nicho810/XIAO-PowerBread/Docs/Images/webFlashTools/1.webp

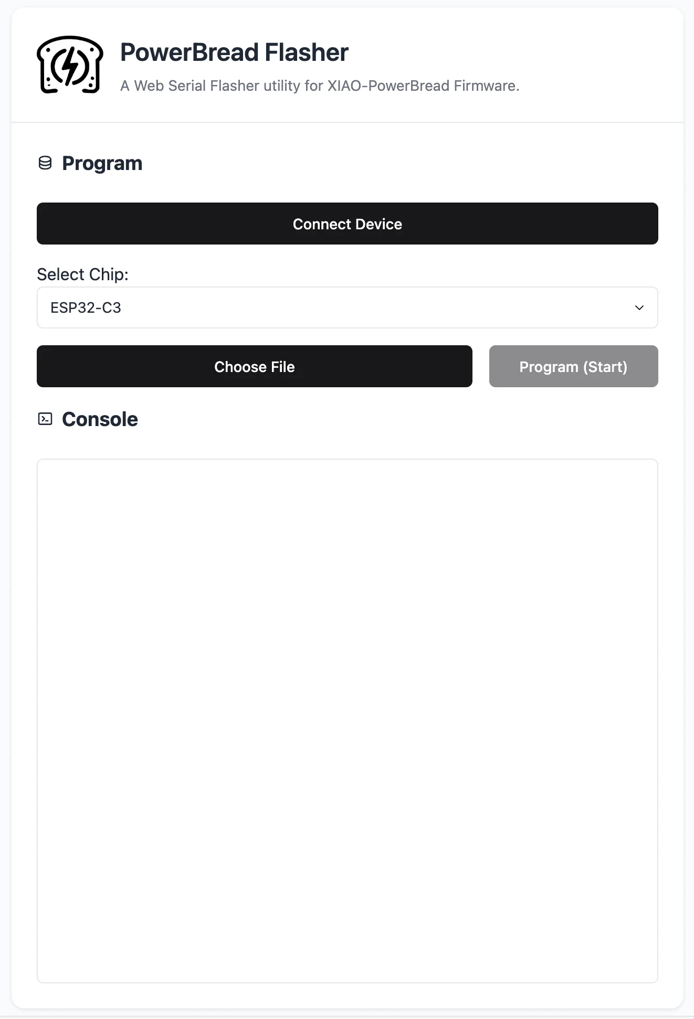
Docs/Images/webFlashTools/1.webp
