nicho810/XIAO-PowerBread/(threads)

Thread 9 (2024-12-19):

Upgrade for XIAO

CWGwaltney, 2024-12-19:
Can we upgrade this design for XIAO make a power board for lipo and solar charging and powering XIAO projects in the field... similar to Seeed Lipo rider... I would like to help with ideas... I am looking forward to getting one of these devices to test! can i be part of a team? reach out to me!

CWGwaltney, 2024-12-19:
https://www.seeedstudio.com/LiPo-Rider-Pro.html

I am on the seeed forum alot... I al
m looking to work with someone like yourself to build new XIAO exosystem items and LoRa Meshtastic I think i have good ideas  I am an engineer but do not understand all about making the products

basicly I would like to see your product merged with lipo rider product and maybe 18650 to provide a power system for XIAO products, power would be USB-3.7v Lipo, solar and/ or 18650

https://www.seeedstudio.com/Seeeduino-XIAO-Expansion-board-p-4746.html

https://www.seeedstudio.com/Grove-Shield-for-Seeeduino-XIAO-p-4621.html

https://github.com/Seeed-Studio/OSHW-XIAO-Series/discussions/16#discussioncomment-11179238

CWGwaltney, 2024-12-19:
i like the ability to switch 3.3v and 5 v switch from breadboard mode to XIAO mode and maybe add a bank of level shift

CWGwaltney, 2024-12-19:
i like using the "smart" power management IC so data can be feed back to the MCU via IIC instead of "dumb" charge IC  which does not provide data back

CWGwaltney, 2024-12-19:
https://www.seeedstudio.com/Wio-Tracker-1110-Dev-Kit-for-Meshtastic.html

Use this form factor

CWGwaltney, 2025-01-15:
Hello my friend.. I hope all is well!

nicho810, 2025-01-19:
Oops, looks like I missed your message while diving into another project. You’re totally right about the smart LiPo charger—having battery status, charge/discharge rate, and capacity would be awesome. The only thing is, for the XIAO-PowerBread project, the current sensor and LCD consume quite a bit of power, so it’s not the best fit for battery operation. A better approach for smart battery monitoring in IoT devices could be a dedicated module with a battery charge IC, a coulomb counter, a high-efficiency DC-DC converter, and a low-power MCU to handle the data and output it via I2C.

CWGwaltney, 2025-01-20:
Lets see if we can work on a XIAO project together!

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
