nicho810/XIAO-PowerBread/PCB/v1.2/Schematic_v1.2.pdf

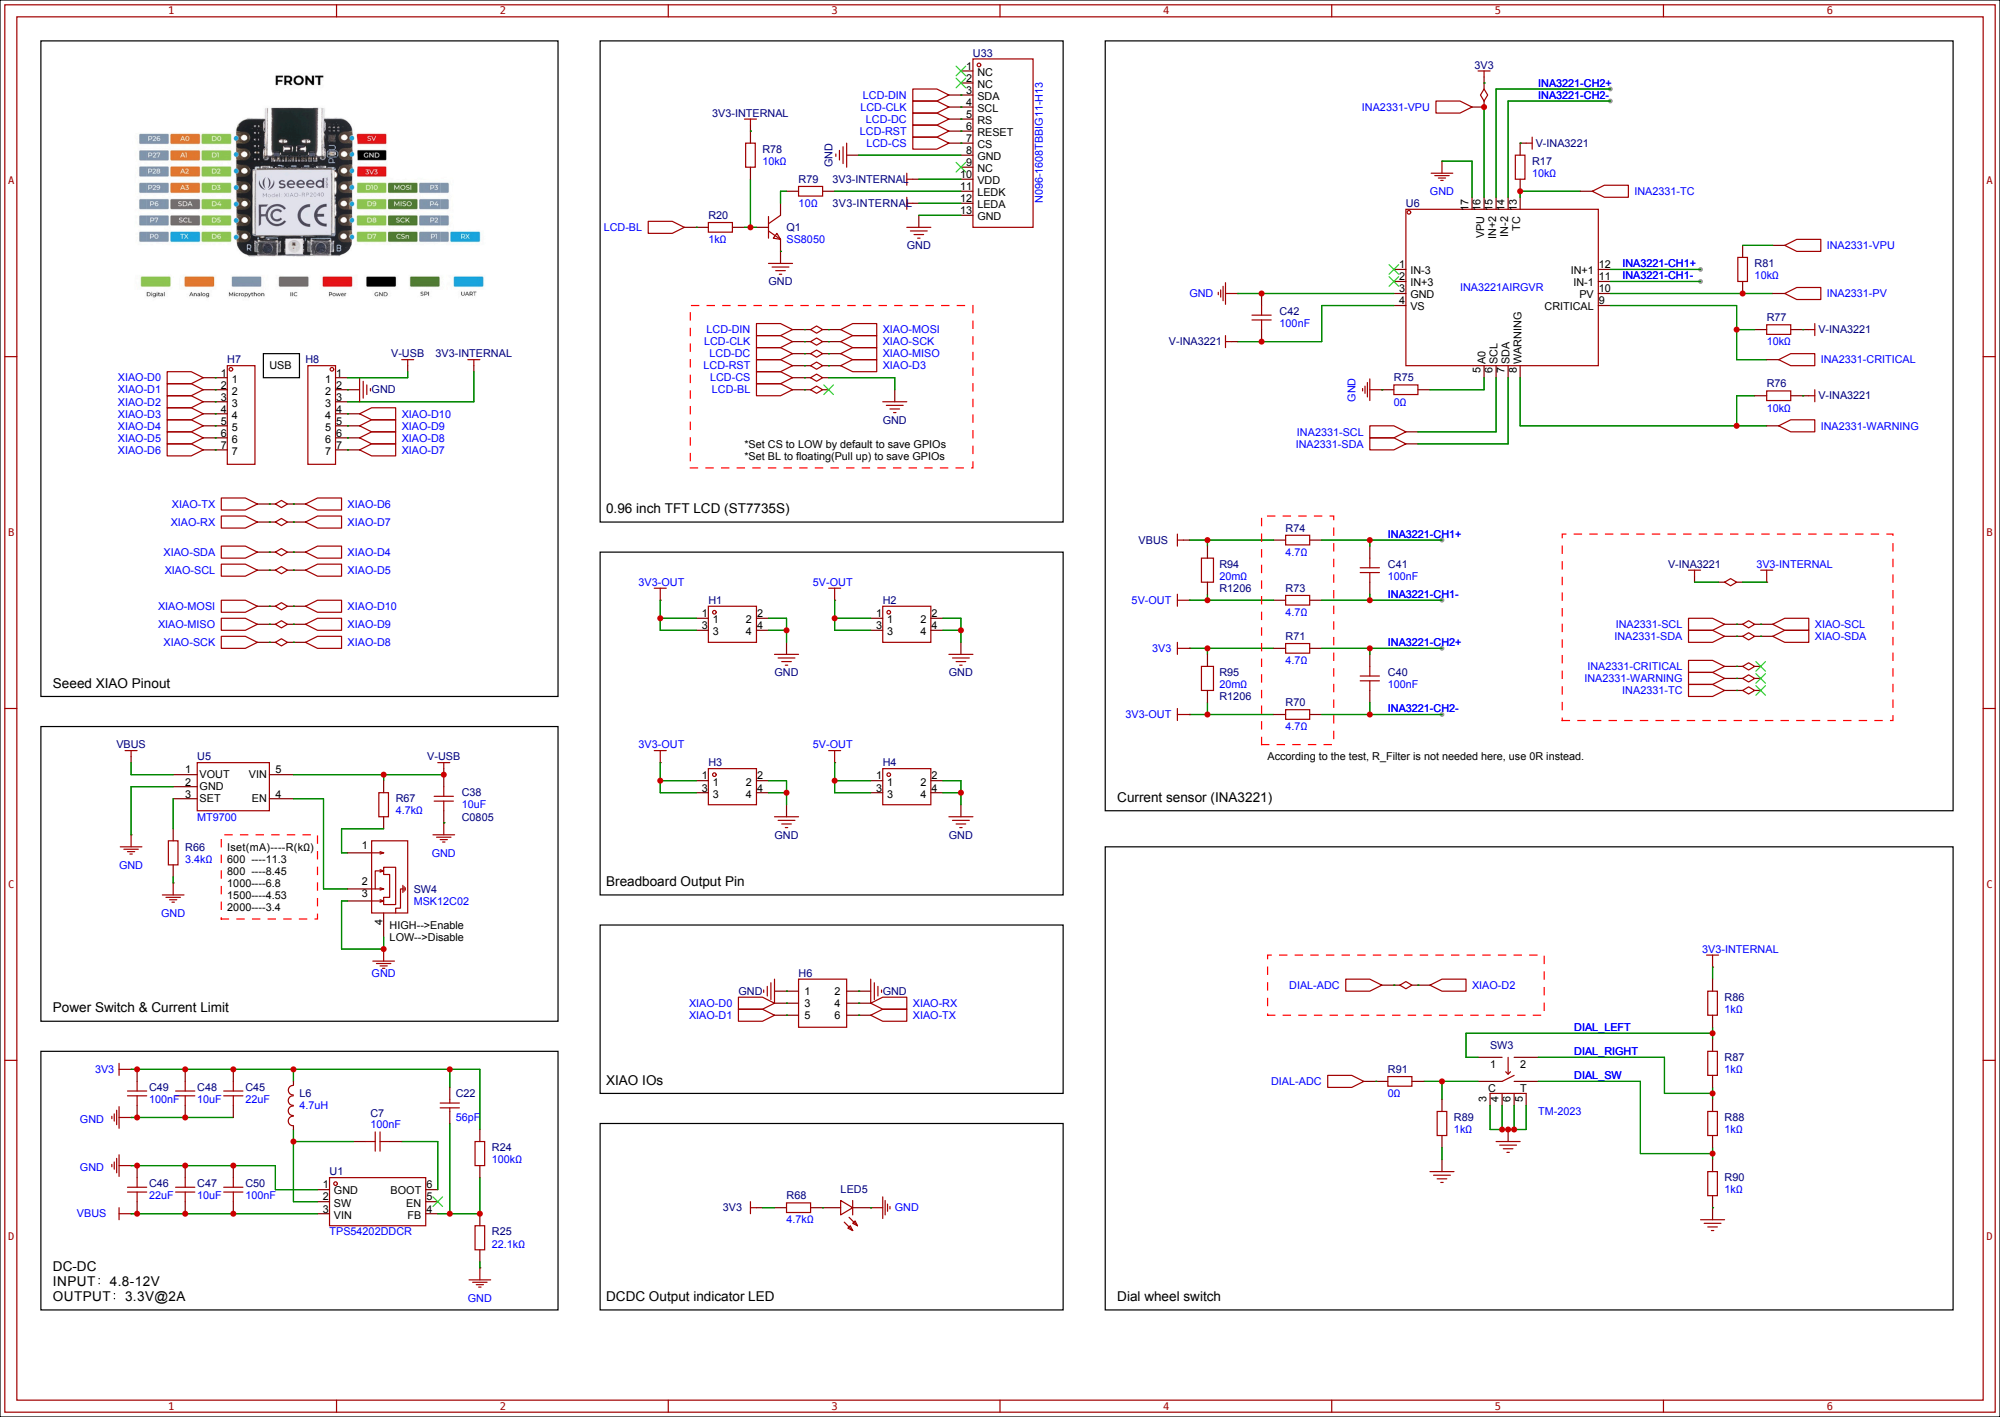
[picture p18: page 1]

*Set CS to LOW by default to save GPIOs
*Set BL to floating(Pull up) to save GPIOs

According to the test, R_Filter is not needed here, use 0R instead.

Power Switch & Current Limit

DCDC Output indicator LED
