nicho810/XIAO-PowerBread/PCB/v1.2/PCB_v1.2.pdf

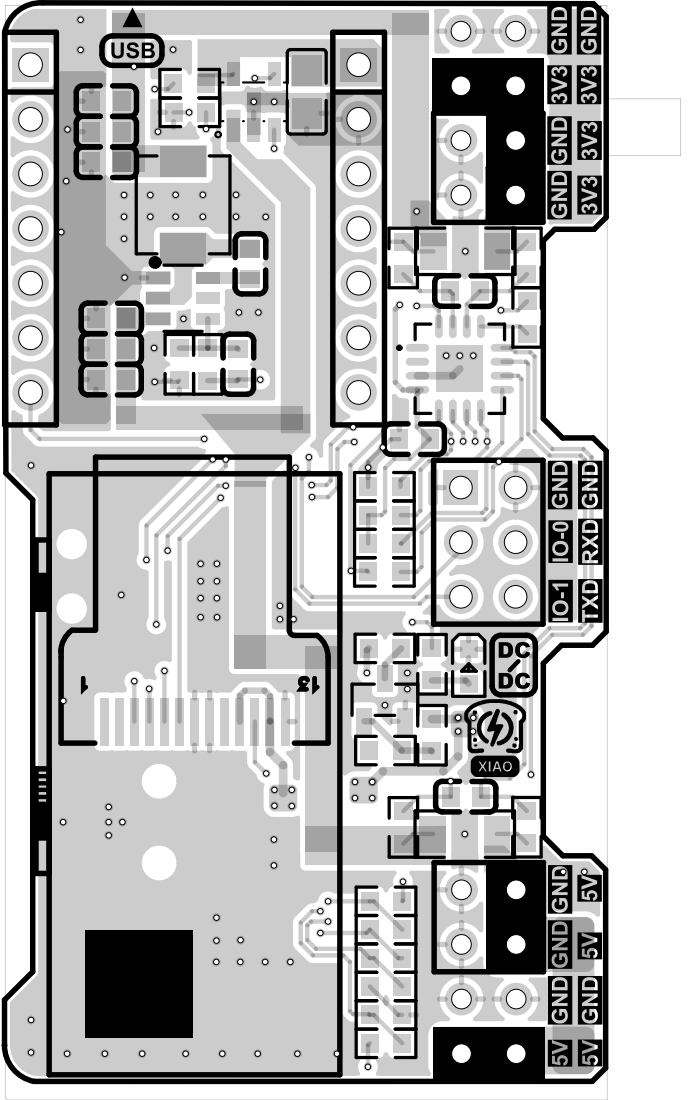
[picture p19: page 1]

GND TXD RXD GND GND 5V 5V

IO-1 IO-0 GND GND GND GND 5V

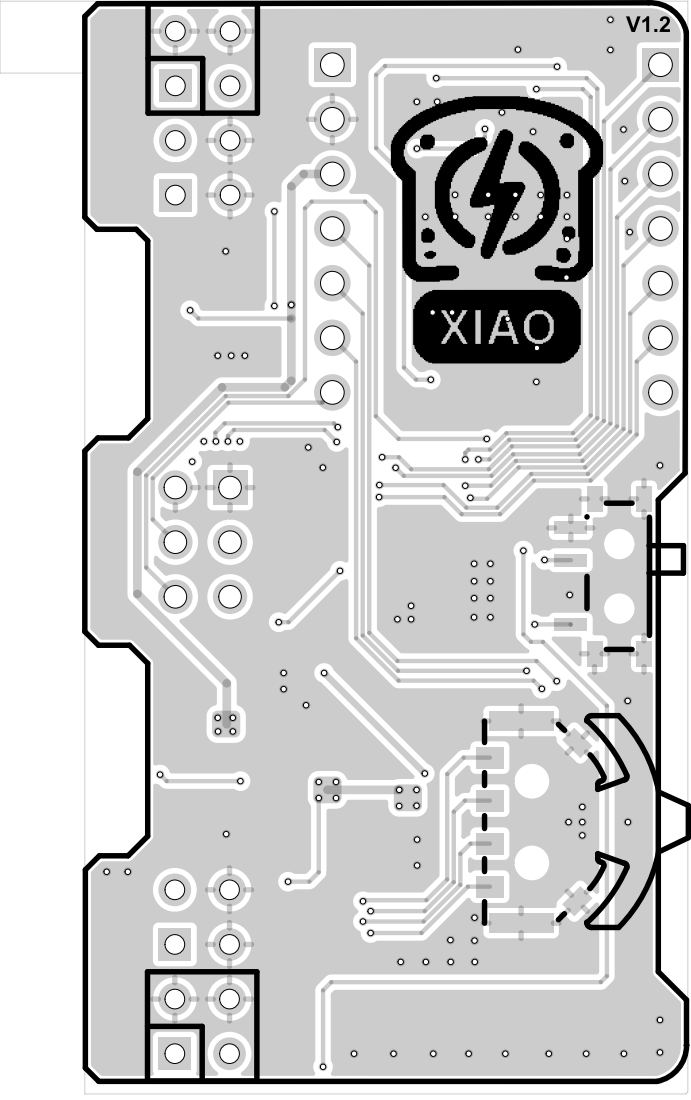
[picture p20: page 2]

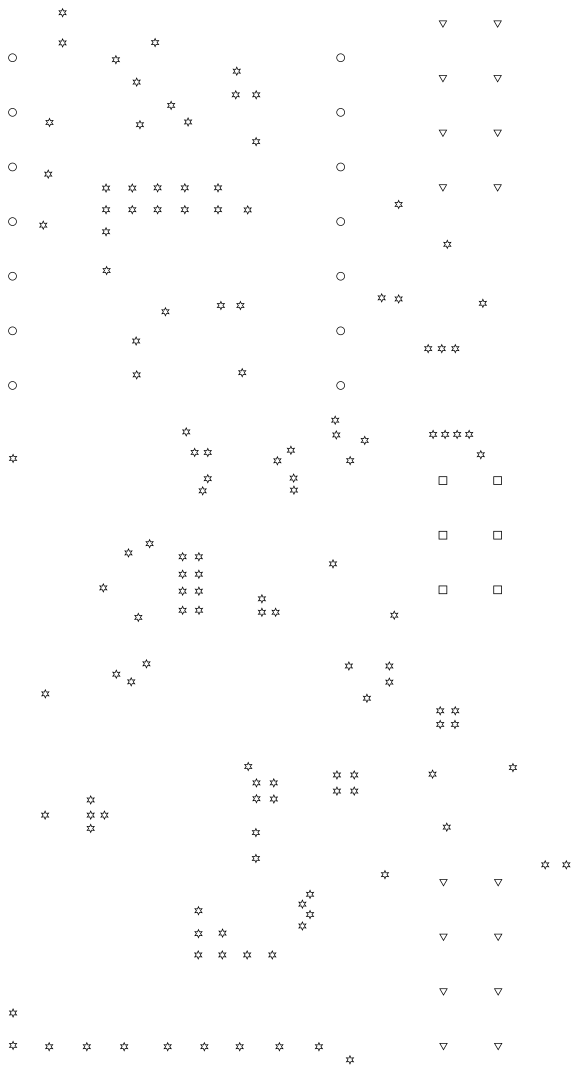
[picture p21: page 3]
