nicho810/XIAO-PowerBread/(commit log)

2024-09-10 add rtos & task to print result via serial
2024-09-16 add PCB and schematic
2024-09-17 update readme and add gerber_BOM
    [BOM_v1.2.xlsx]
2024-09-18 update idle print func
2024-09-18 modify the print func and add compiled uf2 and bin
2024-09-21 refine the rotation and chart channel switch handler
2024-09-26 remove some pcb files that will be update soon
    [BOM_v1.2.xlsx]
2024-09-26 get 4 samples and avarage them
2024-09-27 allow switch channel in data+Chart mode
2024-10-01 Reset the AvgA, AvgM, AvgS, Peak data when switch channel
2024-10-01 remove dial operation debug print
2024-10-06 Create short-circuit test.MOV
2024-10-07 Make led_R blink if INA3221 fail
2024-11-21 update adc threshold
2024-12-16 get it no error, but no working
    [main.cpp]
2024-12-20 add short press to switch mode
2024-12-20 let dial attach as the lvgl input device
2024-12-21 seperate the sensorUpdateTask
2025-01-23 swith board to rpipico and rpipico2, now both board works.
2025-01-24 add notes for spi and i2c config
2025-01-24 update SPI port setting for c3
2025-01-24 improve the I2C init logic
2025-06-26 Enable ESP32-C6
2026-05-16 feat(firmware): v3.0 PlatformIO refactor with binary protocol and RTOS fixes
    - Archive v1.x Arduino firmware as [Archived] XPB-Firmware-Arduino.zip
    - Rename entry file to main.cpp and seed GEB fractal docs (CLAUDE.md
    per library) across all PlatformIO modules
    - Extract xpb_display module so main.cpp no longer drives LCD/LVGL directly
    - Eliminate ABBA deadlock in sensorUpdateTask, reducing it to a pure
    data producer
    - Integrate XPB Binary Protocol v1.2: PC START command auto-switches
    to 100Hz binary stream; add streaming reconnect semantics doc
    - Add RP2040 hardware protocol simulator under debug/, dropping the
    PTY/socat abstraction layer for direct USB
    - Remove debug prints from lvgl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
    [main.cpp]
2026-05-16 docs(images): convert PNG/JPG assets to WebP and add Web Console screenshots
    - Replace all docs/images/*.png and *.jpg with WebP equivalents
    - Add web-console/{light-mode,dark-mode,web-console-cover}.webp
    - Update flash-firmware-for-esp32-series.md image references
2026-05-16 docs(readme-de): sync German README with v3.0 (Web Console, WebP images)
2026-05-16 docs(readme): add ESP32-C6 to v3.0 supported boards
    v3.0 firmware now supports XIAO ESP32-S3, ESP32-C3 and ESP32-C6.
    Updated the IMPORTANT banner, supported-boards table, build/flash
    instructions, planned-features TODO, and the v3.0.0 release row
    across all four language READMEs (EN / JP / FR / DE).
2026-05-16 fix(firmware): preserve bootloader flash params in merge-bin.py
    esptool 4.8.x rewrites bootloader header flash_mode/freq during
    merge_bin and recomputes the SHA digest. ESP32-C6 board JSON declares
    qio while the actual bootloader is compiled as dio — the overwrite
    corrupted byte[2] of the image header (0x02 -> 0x00) and caused boot
    failure after flashing the merged image. esptool 4.5.x (used by C3/S3
    via espressif32 platform) preserved the original due to SHA protection,
    masking the bug.
    Switch --flash_mode and --flash_freq to "keep" so esptool reads the
    real values from the bootloader image instead of re-deriving them from
    board config. Verified: byte[2] of merged.bin now matches standal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
    [merge-bin.py]
2026-05-16 chore(release): publish v3.0.0 ESP32 merged binaries
    Add release artifacts for XIAO ESP32-C3, ESP32-S3 and ESP32-C6 under
    Firmware/Release firmware/3.0.0/, matching the 2.0.1 layout: a
    per-board folder with bootloader.bin, partitions.bin, firmware.bin,
    firmware.elf, firmware.map and two-named copies of the merged image
    (firmware-merged.bin + XPB_XIAO-<CHIP>-firmware-merged.bin), plus a
    clean zip archive alongside each folder.
    Merged images can be flashed at offset 0x0 in a single write via
    esptool write_flash, ESP Web Tools or esptool-js.
